tamboekie/flysky_i6x_battery_mod/README_files/pasted_image003.jpg

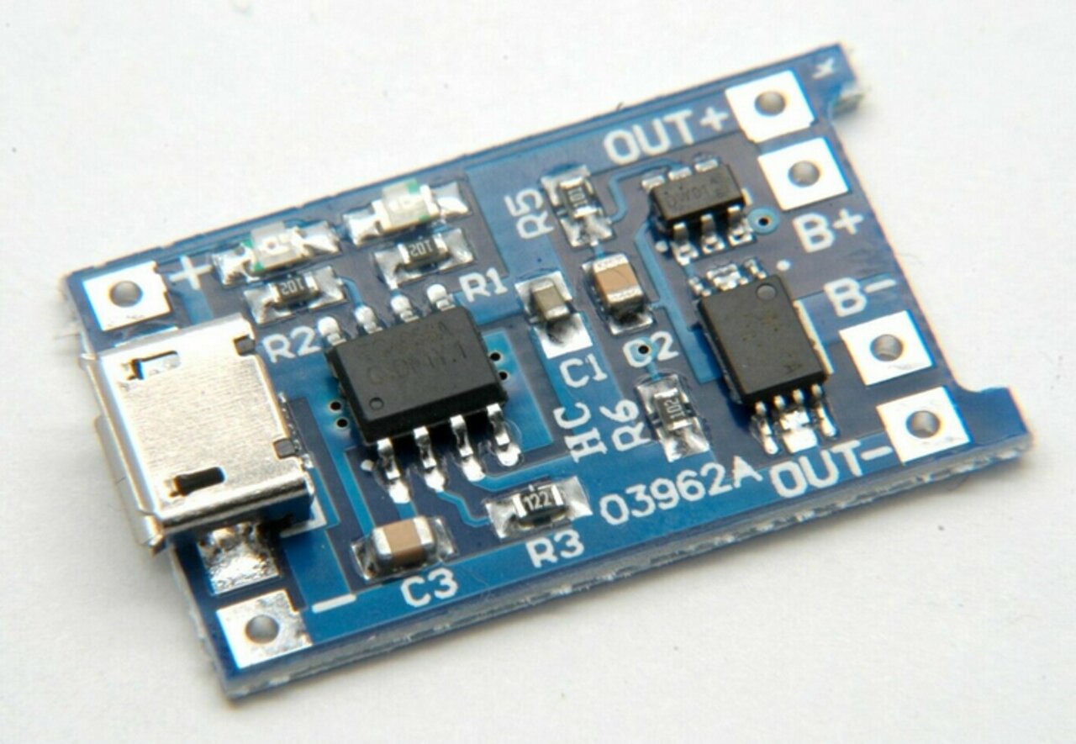
README_files/pasted_image003.jpg
