tamboekie/flysky_i6x_battery_mod/(commit log)

2020-07-28 Add battmonitor.ino - the Arduino UNO monitor
2020-07-28 More cleanup
    Fix some bad writing.
    Link to Arduino sketch.
